crikeyk/PoV_display_PoC/Firmware/debug/capture/capture.csv

t_s | raw_counts | accel_g | phase_rad | position | omega_rad_s | pace_hz | locked | event
0.00000 | -11 | -0.08268 |  |  | 0.0000 |  | 0 | left_end
0.00293 | -29 | -0.22272 |  |  | 0.0000 |  | 0
0.00781 | -37 | -0.28496 |  |  | 0.0000 |  | 0
0.01074 | -56 | -0.43278 |  |  | 0.0000 |  | 0
0.01562 | -62 | -0.47946 |  |  | 0.0000 |  | 0
0.01855 | -73 | -0.56504 |  |  | 0.0000 |  | 0
0.02343 | -77 | -0.59616 |  |  | 0.0000 |  | 0
0.02636 | -81 | -0.62728 |  |  | 0.0000 |  | 0
0.03124 | -78 | -0.60394 |  |  | 0.0000 |  | 0
0.03417 | -67 | -0.51836 |  |  | 0.0000 |  | 0
0.03905 | -63 | -0.48724 |  |  | 0.0000 |  | 0
0.04198 | -56 | -0.43278 |  |  | 0.0000 |  | 0
0.04686 | -54 | -0.41722 |  |  | 0.0000 |  | 0
0.04979 | -50 | -0.38610 |  |  | 0.0000 |  | 0
0.05467 | -48 | -0.37054 |  |  | 0.0000 |  | 0
0.05760 | -45 | -0.34720 |  |  | 0.0000 |  | 0
0.06248 | -46 | -0.35498 |  |  | 0.0000 |  | 0
0.06541 | -46 | -0.35498 |  |  | 0.0000 |  | 0
0.07029 | -46 | -0.35498 |  |  | 0.0000 |  | 0
0.07322 | -46 | -0.35498 |  |  | 0.0000 |  | 0
0.07810 | -47 | -0.36276 |  |  | 0.0000 |  | 0
0.08103 | -47 | -0.36276 |  |  | 0.0000 |  | 0
0.08591 | -50 | -0.38610 |  |  | 0.0000 |  | 0
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
