crikeyk/PoV_display_PoC/PCB/POV display.kicad_pcb

## KiCad design PCB/POV display.kicad_pcb (2026-10-05)

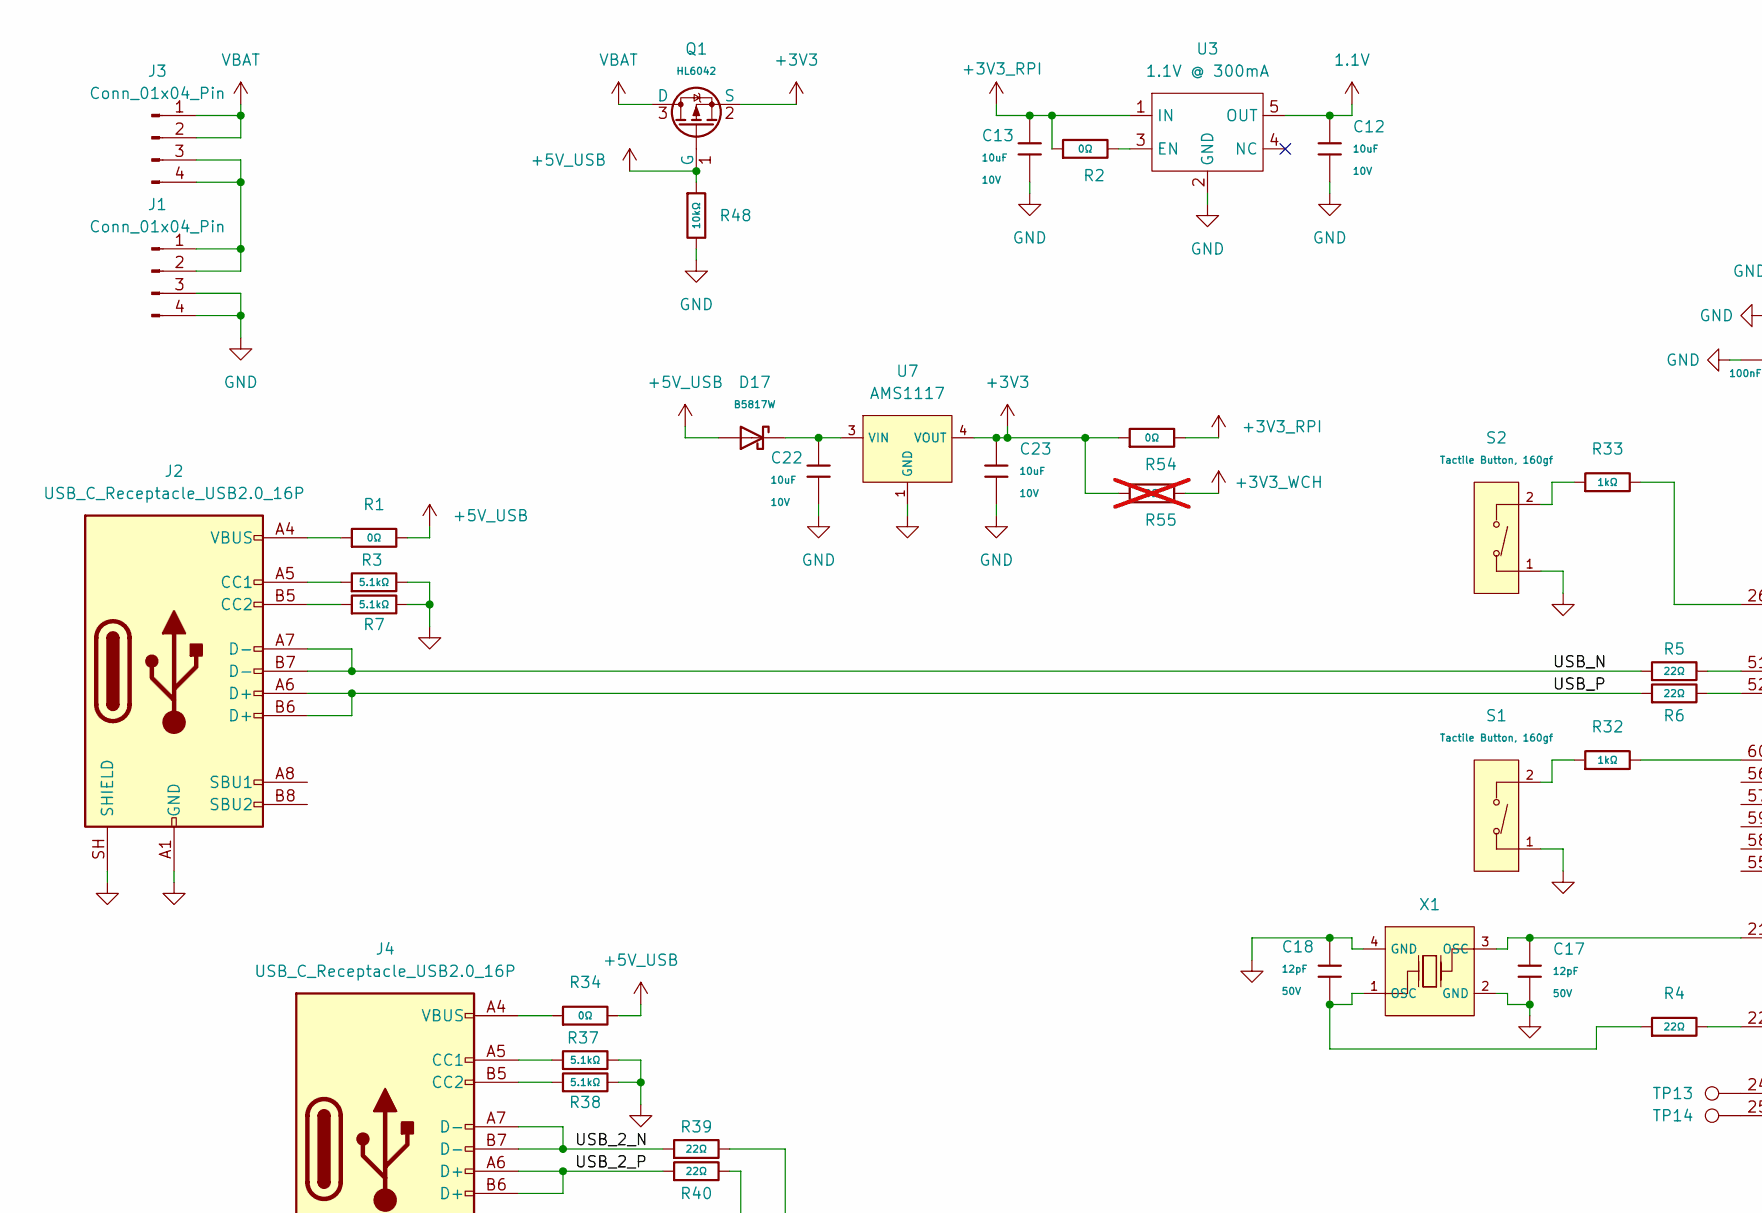
[picture p1: schematic POV display.kicad_sch, part in row 1, column 1]

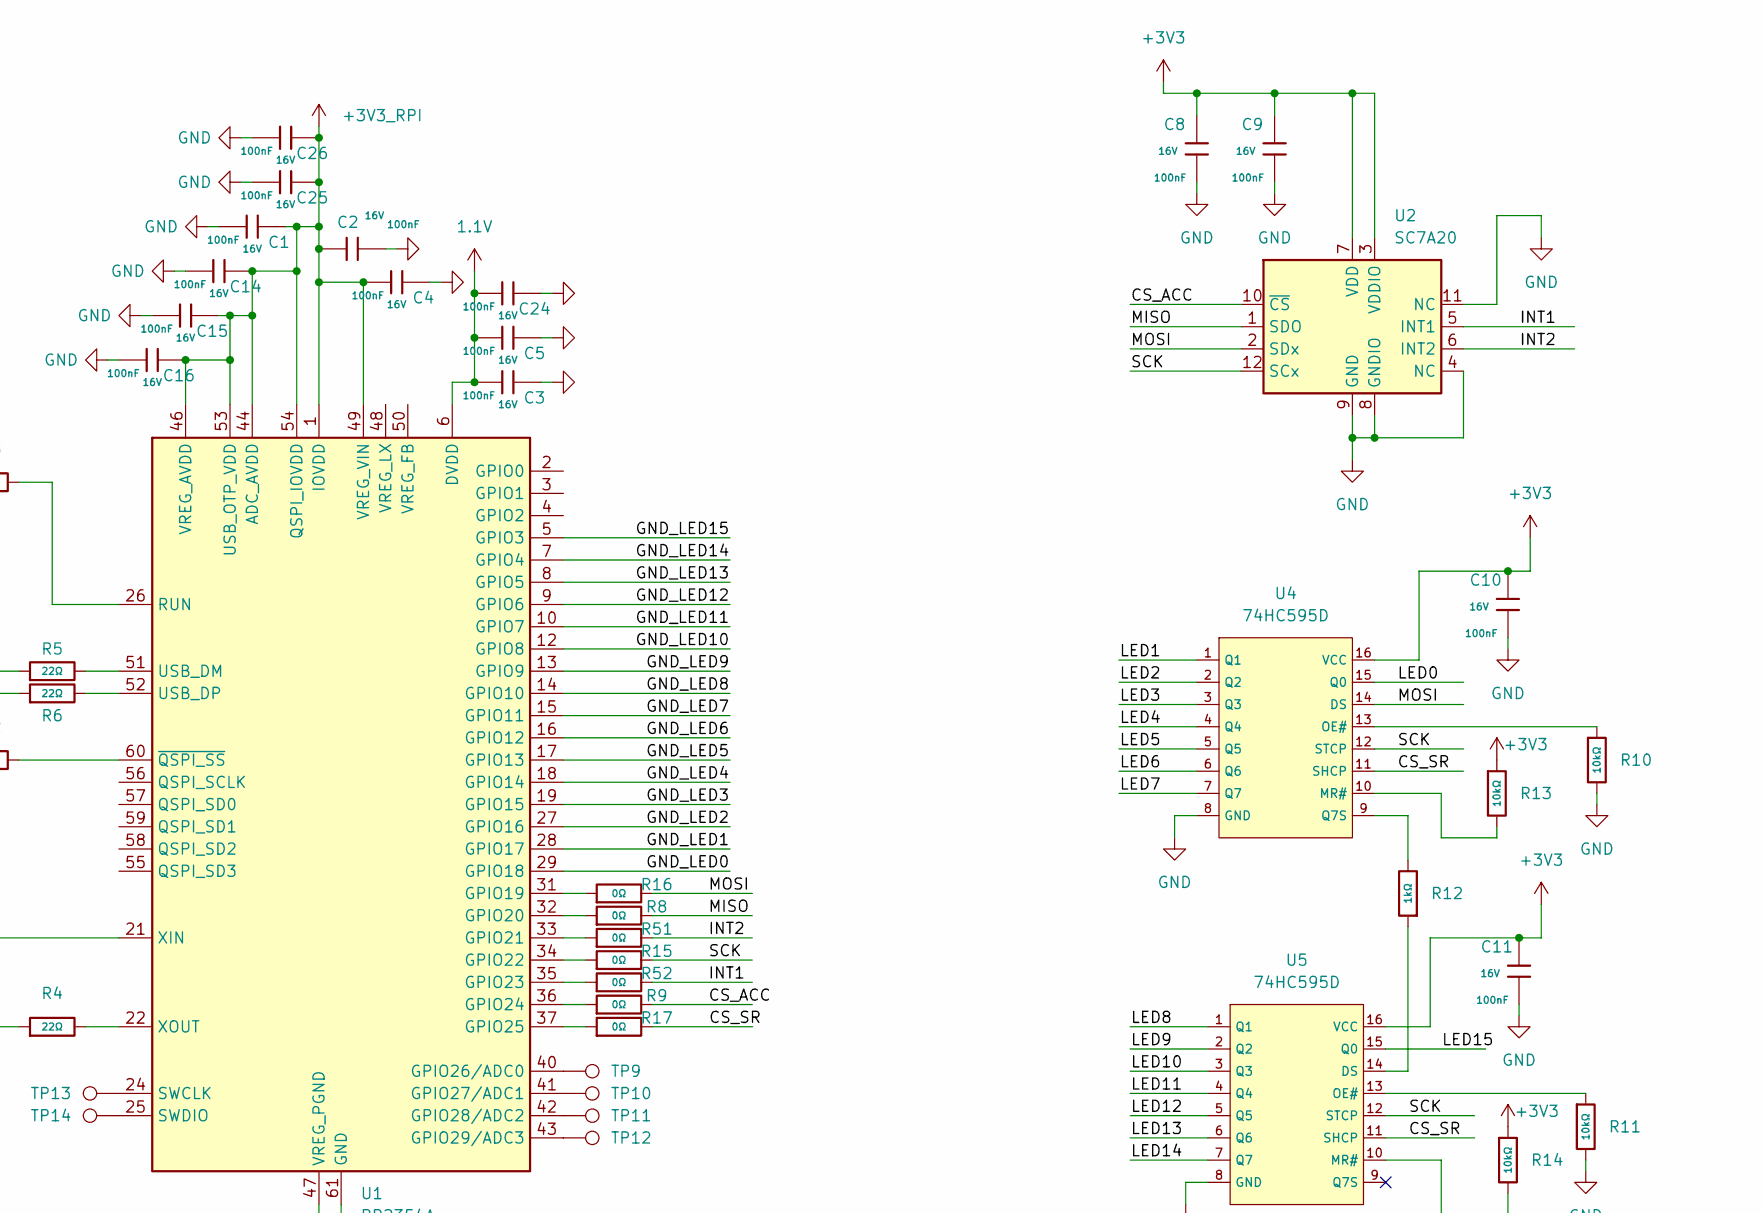
[picture p2: schematic POV display.kicad_sch, part in row 1, column 2]

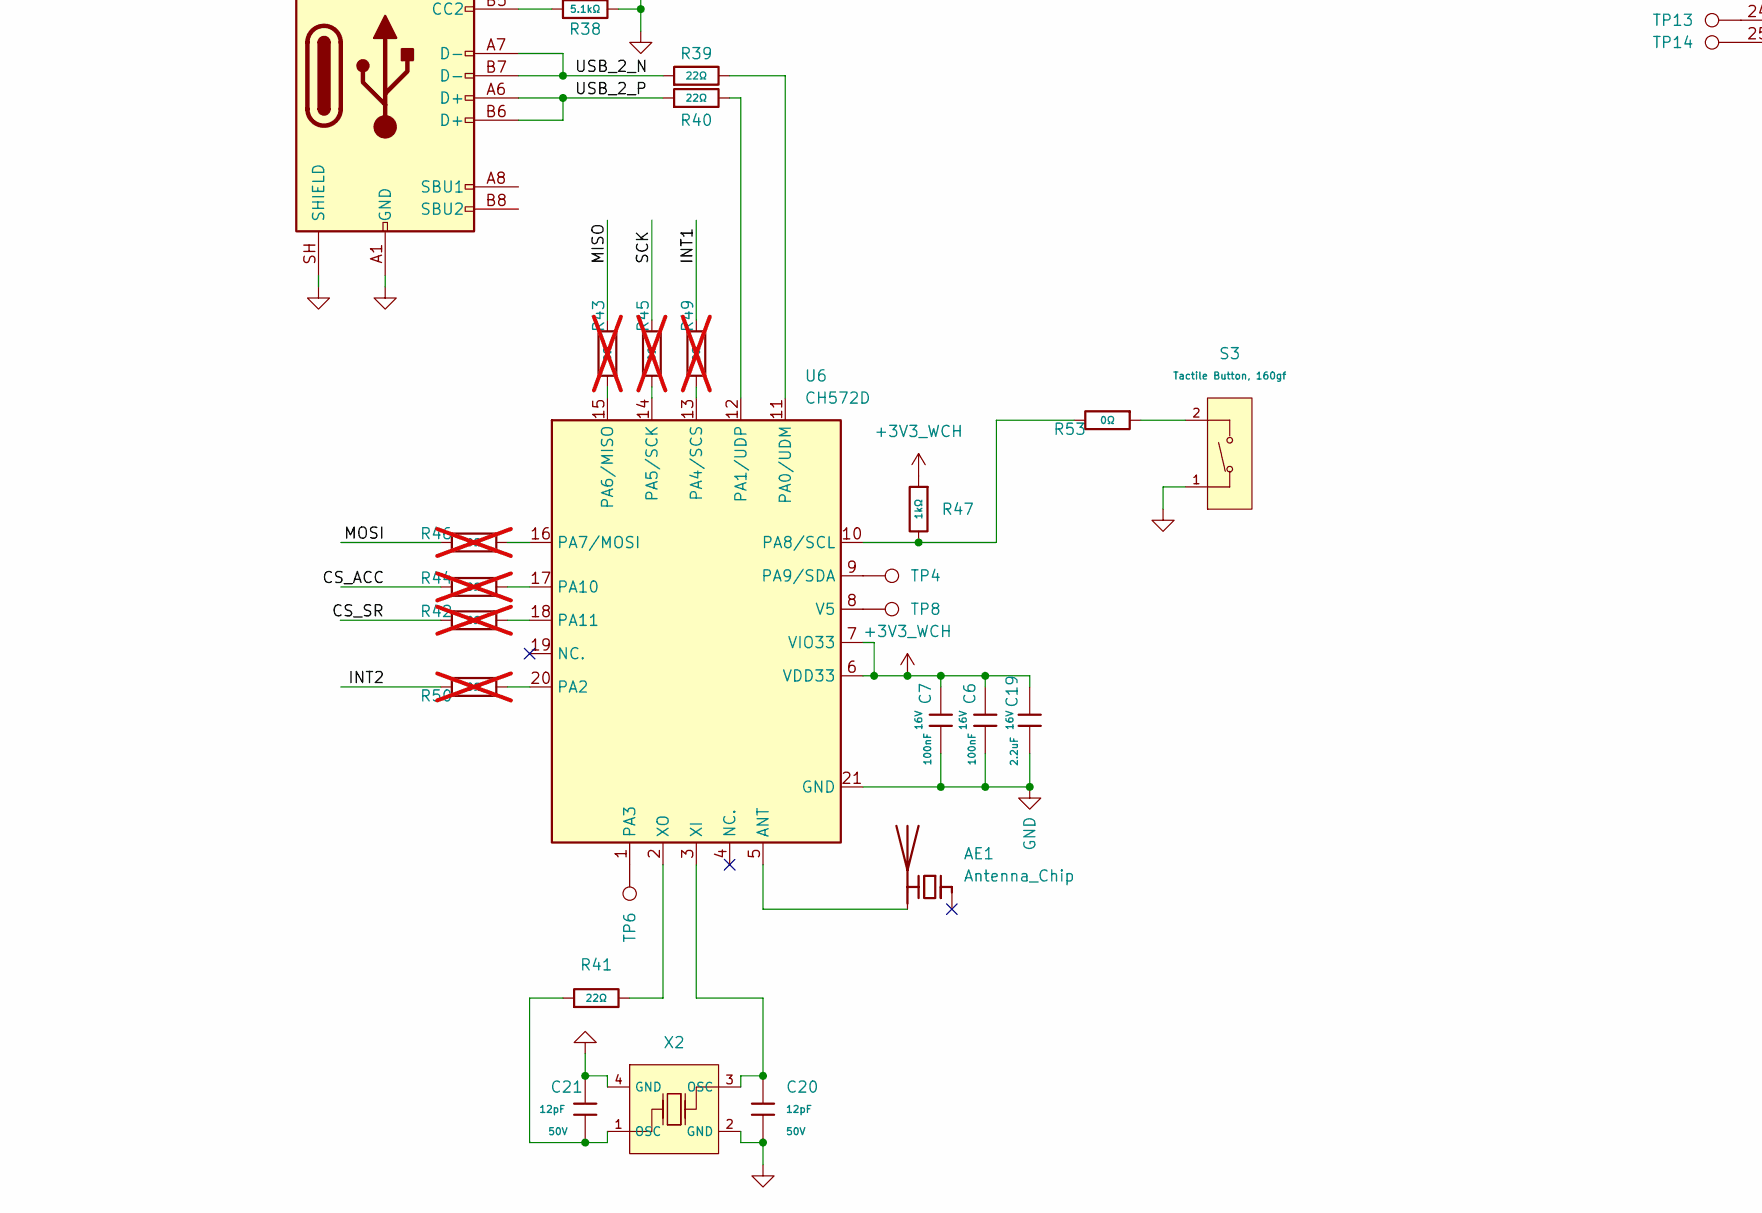
[picture p3: schematic POV display.kicad_sch, part in row 2, column 1]

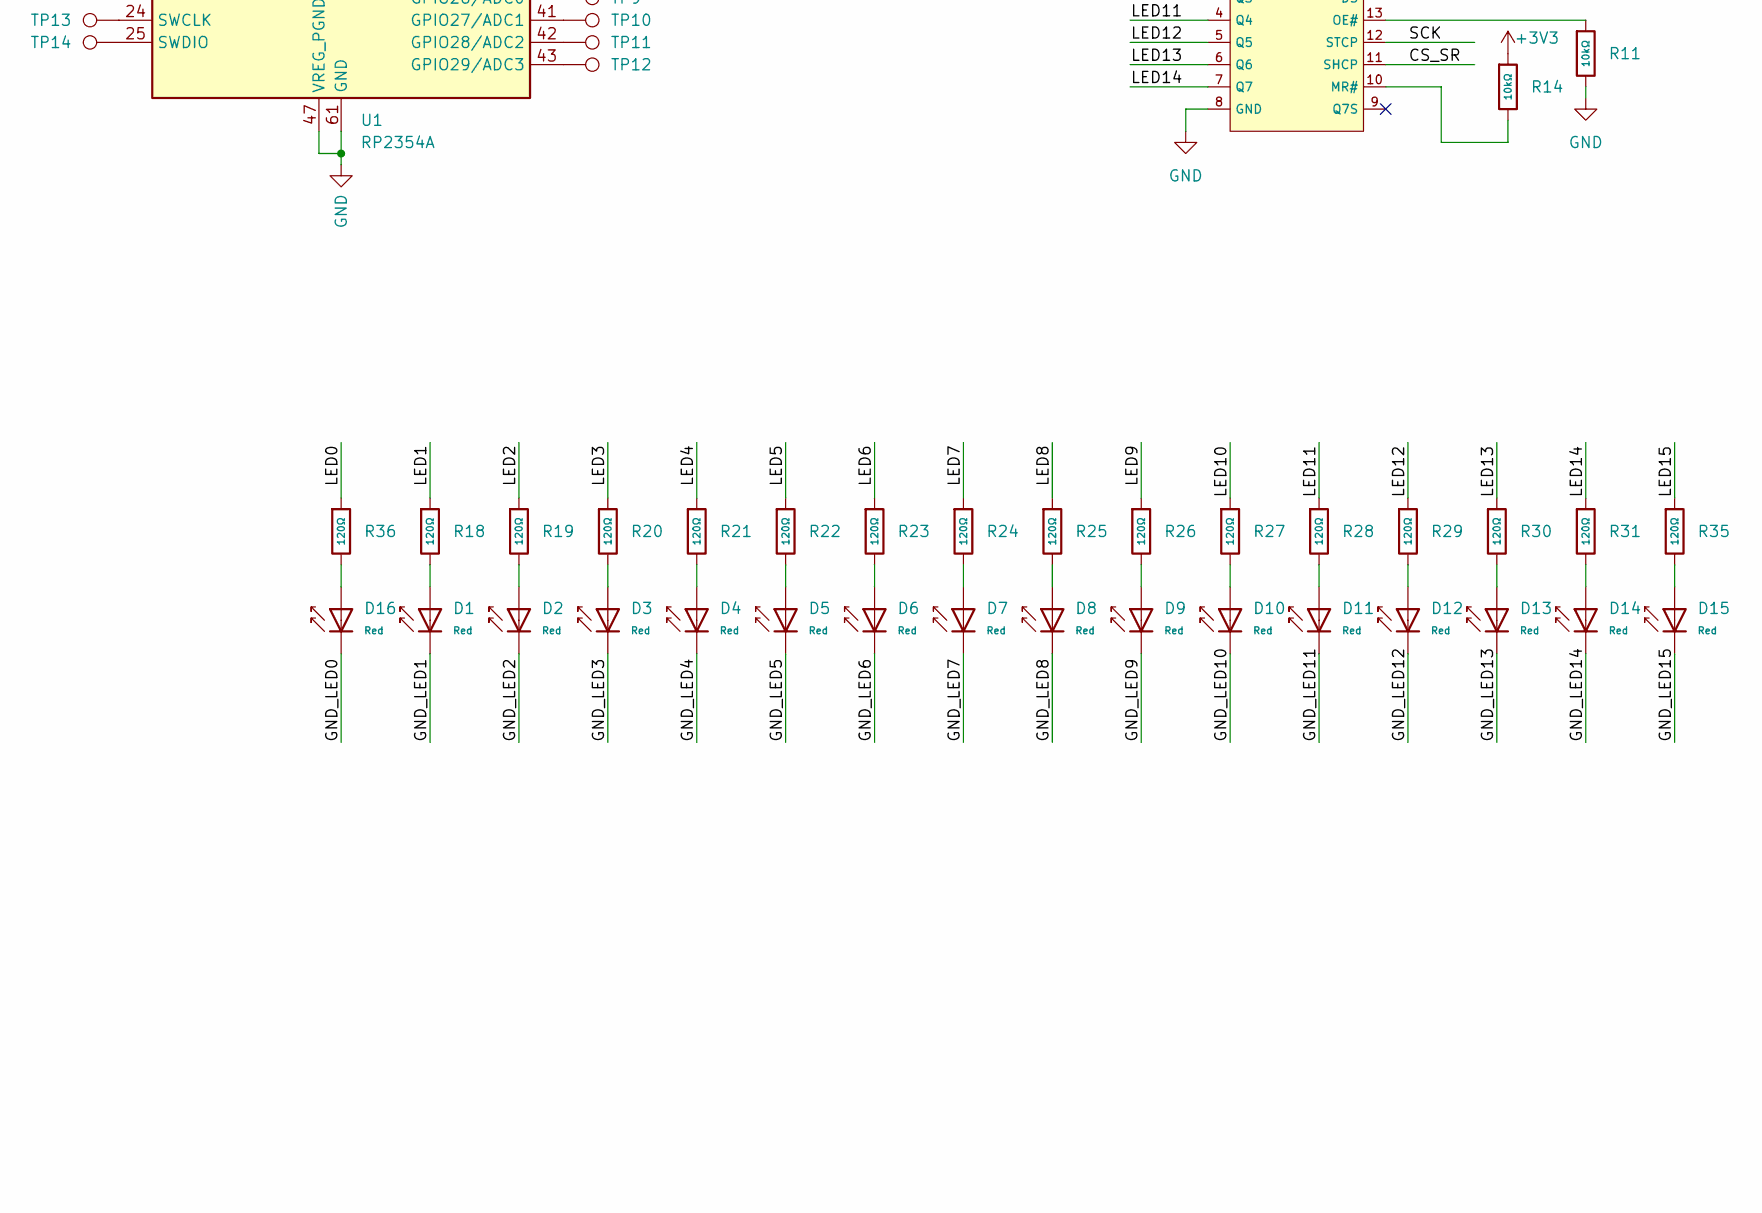
[picture p4: schematic POV display.kicad_sch, part in row 2, column 2]

Parts:
AE1: Antenna_Chip; C_1206_3216Metric; LCSC C127629
C1, C2, C3, C4, C5, C6, C7, C8, C9, C10, C11, C14, C15, C16, C24, C25, C26: 100nF; C_0402; Voltage Rated 16V; Tolerance ±10%; Part CL05B104KO5NNNC; LCSC C1525
C12, C13, C22, C23: 10uF; C_0603; Voltage Rated 10V; Tolerance ±10%; Part CL10A106KP8NNNC; LCSC C19702
C17, C18, C20, C21: 12pF; C_0402; Voltage Rated 50V; Tolerance ±5%; Part 0402CG120J500NT; LCSC C1547
C19: 2.2uF; C_0603; Voltage Rated 16V; Tolerance ±10%; Part CL10A225KO8NNNC; LCSC C23630
D1, D2, D3, D4, D5, D6, D7, D8, D9, D10, D11, D12, D13, D14, D15, D16: Red; D_0603; Part KT-0603R; LCSC C2286
D17: B5817W; D_SOD-123; Forward Voltage (Vf@If) 0.45V@1.0A; Reverse Voltage (Vr) 20V; Part B5817W; LCSC C7420328
J1, J3: Conn_01x04_Pin; BC-8200 AAA Battery clip
J2, J4: USB_C_Receptacle_USB2.0_16P; USB_C_Receptacle_HRO_TYPE-C-31-M-12; LCSC C165948
Q1: HL6042; Q_SOT-23; Part HL6042; LCSC C28646264
R1, R2, R8, R9, R15, R16, R17, R34, R51, R52, R53, R54: 0Ω; R_0402; Overload Voltage (Max) 50V; Tolerance ±1%; Part 0402WGF0000TCE; LCSC C17168
R3, R7, R37, R38: 5.1kΩ; R_0402; Overload Voltage (Max) 50V; Tolerance ±1%; Part 0402WGF5101TCE; LCSC C25905
R4, R5, R6, R39, R40, R41: 22Ω; R_0402; Overload Voltage (Max) 50V; Tolerance ±1%; Part 0402WGF220JTCE; LCSC C25092
R10, R11, R13, R14: 10kΩ; R_0603; Overload Voltage (Max) 75V; Tolerance ±1%; Part 0603WAF1002T5E; LCSC C25804
R12: 1kΩ; R_0603; Overload Voltage (Max) 75V; Tolerance ±1%; Part 0603WAF1001T5E; LCSC C21190
R18, R19, R20, R21, R22, R23, R24, R25, R26, R27, R28, R29, R30, R31, R35, R36: 120Ω; R_0603; Overload Voltage (Max) 75V; Tolerance ±1%; Part 0603WAF1200T5E; LCSC C22787
R32, R33, R47: 1kΩ; R_0402; Overload Voltage (Max) 50V; Tolerance ±1%; Part 0402WGF1001TCE; LCSC C11702
R42, R43, R44, R45, R46, R49, R50, R55: 0Ω; R_0402; Overload Voltage (Max) 50V; Tolerance ±1%; Part 0402WGF0000TCE; LCSC C17168; not fitted
R48: 10kΩ; R_0402; Overload Voltage (Max) 50V; Tolerance ±1%; Part 0402WGF1002TCE; LCSC C25744
S1, S2, S3: Tactile Button, 160gf; SW_TS-1088-AR02016; Voltage Rating (Dc) 12V; Part TS-1088-AR02016; LCSC C720477
TP4, TP6, TP8, TP9, TP10, TP11, TP12, TP13, TP14: TestPoint; TestPoint_Pad_D1.0mm
U1: RP2354A; QFN-60-1EP_7x7mm_P0.4mm_EP3.4x3.4mm; LCSC C41378174
U2: SC7A20; LGA-12_2x2mm_P0.5mm; LCSC C19274408
U3: 1.1V @ 300mA; SOT-23-5; LCSC C485147
U4, U5: 74HC595D; SOIC-16_L9.9-W3.9-P1.27-LS6.0-BL; Supply Voltage 2V~6V; Part 74HC595D,118; LCSC C5947
U6: CH572D; QFN-20-1EP_3x3mm_P0.4mm_EP1.65x1.65mm
U7: AMS1117; SOT-223-3_L6.5-W3.4-P2.30-LS7.0-BR; Output Voltage 3.3V; Dropout Voltage 1.3V@(800mA); Part AMS1117-3.3; LCSC C6186
X1: X322512MSB4SI; CRYSTAL-SMD_4P-L3.2-W2.5-BL; Frequency Tolerance ±10ppm; Part X322512MSB4SI; LCSC C9002
X2: Y201632MFBCX; Crystal_SMD_2016-4Pin_2.0x1.6mm; Frequency Tolerance ±10ppm; Part Y201632MFBCX; LCSC C49158176

Connections:
1.1V: C3.2, C5.2, C12.1, C24.2, U1.6 (DVDD), U1.23 (DVDD), U1.39 (DVDD), U3.5 (OUT)
+3V3: C8.1, C9.1, C10.1, C11.1, C23.1, Q1.2 (S), R13.1, R14.1, R54.1, R55.1, U2.3 (VDDIO), U2.7 (VDD), U4.16 (VCC), U5.16 (VCC), U7.2 (VOUT), U7.4 (VOUT)
+3V3_RPI: C1.1, C2.1, C4.2, C13.1, C14.1, C15.1, C16.1, C25.1, C26.1, R2.1, R54.2, U1.1 (IOVDD), U1.11 (IOVDD), U1.20 (IOVDD), U1.30 (IOVDD), U1.38 (IOVDD), U1.44 (ADC_AVDD), U1.45 (IOVDD), U1.46 (VREG_AVDD), U1.49 (VREG_VIN), U1.53 (USB_OTP_VDD), U1.54 (QSPI_IOVDD), U3.1 (IN)
+3V3_WCH: C6.1, C7.1, C19.1, R47.1, R55.2, U6.6 (VDD33), U6.7 (VIO33)
+5V_USB: D17.2, Q1.1 (G), R1.2, R34.2, R48.1
/CS_ACC: R9.2, R44.2, U2.10 (~CS)
/CS_SR: R17.2, R42.2, U4.11 (SHCP), U5.11 (SHCP)
/GND_LED0: D16.1, U1.29 (GPIO18)
/GND_LED1: D1.1, U1.28 (GPIO17)
/GND_LED2: D2.1, U1.27 (GPIO16)
/GND_LED3: D3.1, U1.19 (GPIO15)
/GND_LED4: D4.1, U1.18 (GPIO14)
/GND_LED5: D5.1, U1.17 (GPIO13)
/GND_LED6: D6.1, U1.16 (GPIO12)
/GND_LED7: D7.1, U1.15 (GPIO11)
/GND_LED8: D8.1, U1.14 (GPIO10)
/GND_LED9: D9.1, U1.13 (GPIO9)
/GND_LED10: D10.1, U1.12 (GPIO8)
/GND_LED11: D11.1, U1.10 (GPIO7)
/GND_LED12: D12.1, U1.9 (GPIO6)
/GND_LED13: D13.1, U1.8 (GPIO5)
/GND_LED14: D14.1, U1.7 (GPIO4)
/GND_LED15: D15.1, U1.5 (GPIO3)
/INT1: R49.2, R52.2, U2.5 (INT1)
/INT2: R50.2, R51.2, U2.6 (INT2)
/LED0: R36.1, U4.15 (Q0)
/LED1: R18.1, U4.1 (Q1)
/LED2: R19.1, U4.2 (Q2)
/LED3: R20.1, U4.3 (Q3)
/LED4: R21.1, U4.4 (Q4)
/LED5: R22.1, U4.5 (Q5)
/LED6: R23.1, U4.6 (Q6)
/LED7: R24.1, U4.7 (Q7)
/LED8: R25.1, U5.1 (Q1)
/LED9: R26.1, U5.2 (Q2)
/LED10: R27.1, U5.3 (Q3)
/LED11: R28.1, U5.4 (Q4)
/LED12: R29.1, U5.5 (Q5)
/LED13: R30.1, U5.6 (Q6)
/LED14: R31.1, U5.7 (Q7)
/LED15: R35.1, U5.15 (Q0)
/MISO: R8.2, R43.2, U2.1 (SDO)
/MOSI: R16.2, R46.2, U2.2 (SDx), U4.14 (DS)
/SCK: R15.2, R45.2, U2.12 (SCx), U4.12 (STCP), U5.12 (STCP)
/USB_2_N: J4.A7 (D-), J4.B7 (D-), R39.1
/USB_2_P: J4.A6 (D+), J4.B6 (D+), R40.1
/USB_N: J2.A7 (D-), J2.B7 (D-), R5.1
/USB_P: J2.A6 (D+), J2.B6 (D+), R6.1
GND: C1.2, C2.2, C3.1, C4.1, C5.1, C6.2, C7.2, C8.2, C9.2, C10.2, C11.2, C12.2, C13.2, C14.2, C15.2, C16.2, C17.2, C18.2, C19.2, C20.2, C21.2, C22.2, C23.2, C24.1, C25.2, C26.2, J1.3, J1.4, J2.A1 (GND), J2.A12 (GND), J2.B1 (GND), J2.B12 (GND), J2.SH (SHIELD), J4.A1 (GND), J4.A12 (GND), J4.B1 (GND), J4.B12 (GND), J4.SH (SHIELD), R3.2, R7.2, R10.2, R11.2, R37.2, R38.2, R48.2, S1.1 (A), S2.1 (A), S3.1 (A), U1.47 (VREG_PGND), U1.61 (GND), U2.4 (NC), U2.8 (GNDIO), U2.9 (GND), U2.11 (NC), U3.2 (GND), U4.8 (GND), U5.8 (GND), U6.21 (GND), U7.1 (GND), X1.2 (GND), X1.4 (GND), X2.2 (GND), X2.4 (GND)
unnamed: AE1.2 (PCB_Trace_2), U6.5 (ANT)
unnamed: C18.1, R4.1, X1.1 (OSC)
unnamed: C21.1, R41.1, X2.1 (OSC)
unnamed: D1.2, R18.2
unnamed: D2.2, R19.2
unnamed: D3.2, R20.2
unnamed: D4.2, R21.2
unnamed: D5.2, R22.2
unnamed: D6.2, R23.2
unnamed: D7.2, R24.2
unnamed: D8.2, R25.2
unnamed: D9.2, R26.2
unnamed: D10.2, R27.2
unnamed: D11.2, R28.2
unnamed: D12.2, R29.2
unnamed: D13.2, R30.2
unnamed: D14.2, R31.2
unnamed: D15.2, R35.2
unnamed: D16.2, R36.2
unnamed: J1.1, J1.2, J3.3, J3.4
unnamed: J2.A5 (CC1), R3.1
unnamed: J2.B5 (CC2), R7.1
unnamed: J2.A4 (VBUS), J2.A9 (VBUS), J2.B4 (VBUS), J2.B9 (VBUS), R1.1
unnamed: J4.A5 (CC1), R37.1
unnamed: J4.B5 (CC2), R38.1
unnamed: J4.A4 (VBUS), J4.A9 (VBUS), J4.B4 (VBUS), J4.B9 (VBUS), R34.1
unnamed: R32.1, S1.2 (B)
unnamed: R33.1, S2.2 (B)
unnamed: R53.1, S3.2 (B)
unnamed: R16.1, U1.31 (GPIO19)
unnamed: R8.1, U1.32 (GPIO20)
unnamed: R51.1, U1.33 (GPIO21)
unnamed: R15.1, U1.34 (GPIO22)
unnamed: R52.1, U1.35 (GPIO23)
unnamed: R9.1, U1.36 (GPIO24)
unnamed: R17.1, U1.37 (GPIO25)
unnamed: TP9.1 (1_1), U1.40 (GPIO26/ADC0)
unnamed: TP10.1 (1_1), U1.41 (GPIO27/ADC1)
unnamed: TP11.1 (1_1), U1.42 (GPIO28/ADC2)
unnamed: TP12.1 (1_1), U1.43 (GPIO29/ADC3)
unnamed: R33.2, U1.26 (RUN)
unnamed: TP13.1 (1_1), U1.24 (SWCLK)
unnamed: TP14.1 (1_1), U1.25 (SWDIO)
unnamed: R5.2, U1.51 (USB_DM)
unnamed: R6.2, U1.52 (USB_DP)
unnamed: C17.1, U1.21 (XIN), X1.3 (OSC)
unnamed: R4.2, U1.22 (XOUT)
unnamed: R32.2, U1.60 (~QSPI_SS)
unnamed: R2.2, U3.3 (EN)
unnamed: R13.2, U4.10 (MR#)
unnamed: R10.1, U4.13 (OE#)
unnamed: R12.2, U4.9 (Q7S)
unnamed: R12.1, U5.14 (DS)
unnamed: R14.2, U5.10 (MR#)
unnamed: R11.1, U5.13 (OE#)
unnamed: R39.2, U6.11 (PA0/UDM)
unnamed: R40.2, U6.12 (PA1/UDP)
unnamed: R50.1, U6.20 (PA2)
unnamed: TP6.1 (1_1), U6.1 (PA3)
unnamed: R49.1, U6.13 (PA4/SCS)
unnamed: R45.1, U6.14 (PA5/SCK)
unnamed: R43.1, U6.15 (PA6/MISO)
unnamed: R46.1, U6.16 (PA7/MOSI)
unnamed: R47.2, R53.2, U6.10 (PA8/SCL)
unnamed: TP4.1 (1_1), U6.9 (PA9/SDA)
unnamed: R44.1, U6.17 (PA10)
unnamed: R42.1, U6.18 (PA11)
unnamed: TP8.1 (1_1), U6.8 (V5)
unnamed: C20.1, U6.3 (XI), X2.3 (OSC)
unnamed: R41.2, U6.2 (XO)
unnamed: C22.1, D17.1, U7.3 (VIN)
VBAT: J3.1, J3.2, Q1.3 (D)

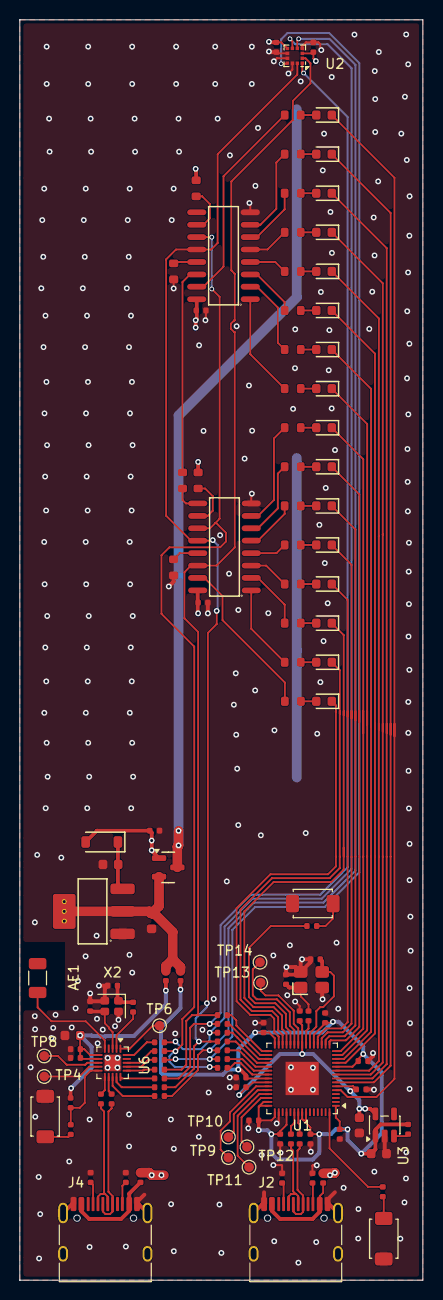
[picture p5: board POV display.kicad_pcb from above]

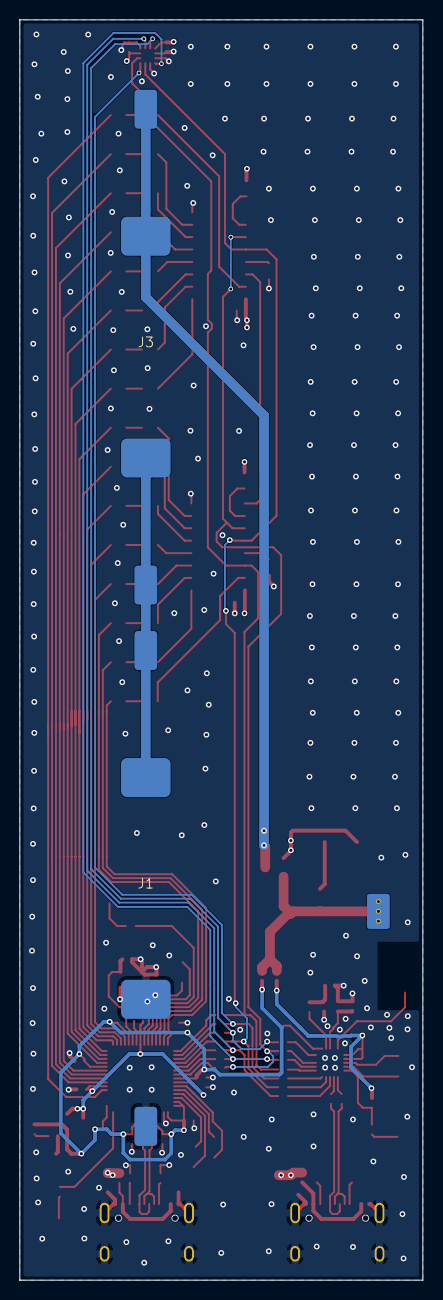
[picture p6: board POV display.kicad_pcb from below]

Board: 4 copper layers, 41.2 x 129.0 mm, 125 parts (2 on the bottom side), 121 nets.
