crikeyk/PoV_display_PoC/Firmware/ch572/src/peripheral_main.c

/********************************** (C) COPYRIGHT *******************************
 * File Name          : main.c
 * Author             : WCH
 * Version            : V1.1
 * Date               : 2020/08/06
 * Description        : 外设从机应用主函数及任务系统初始化
 *********************************************************************************
 * Copyright (c) 2021 Nanjing Qinheng Microelectronics Co., Ltd.
 * Attention: This software (modified or not) and binary are used for 
 * microcontroller manufactured by Nanjing Qinheng Microelectronics.
 *******************************************************************************/

/******************************************************************************/
/* 头文件包含 */
#include "CONFIG.h"
#include "HAL.h"
#include "gattprofile.h"
#include "peripheral.h"
#include "board.h"

void InitUSBDevPara(void);
void InitUSBDevice(void);
void USB_IRQProcessHandler(void);

/*********************************************************************
 * GLOBAL TYPEDEFS
 */
__attribute__((aligned(4))) uint32_t MEM_BUF[BLE_MEMHEAP_SIZE / 4];

#if(defined(BLE_MAC)) && (BLE_MAC == TRUE)
const uint8_t MacAddr[6] = {0x84, 0xC2, 0xE4, 0x03, 0x02, 0x02};
#endif

/*********************************************************************
 * @fn      Main_Circulation
 *
 * @brief   主循环
 *
 * @return  none
 */
__HIGH_CODE
__attribute__((noinline))
void Main_Circulation()
{
    while(1)
    {
        TMOS_SystemProcess();
        USB_IRQProcessHandler();
        board_poll();
    }
}

/*********************************************************************
 * @fn      main
 *
 * @brief   主函数
 *
 * @return  none
 */
int main(void)
{
    // 关闭两线调试
    R16_PIN_ALTERNATE &= ~RB_PIN_DEBUG_EN;
    HSECFG_Capacitance(HSECap_12p);          // board crystal is 32 MHz, 12 pF
    SetSysClock(CLK_SOURCE_HSE_PLL_100MHz);
#if(defined(HAL_SLEEP)) && (HAL_SLEEP == TRUE)
    GPIOA_ModeCfg(GPIO_Pin_All, GPIO_ModeIN_PU);
#endif
    board_init();
    InitUSBDevPara();
    InitUSBDevice();
    board_log("POV> ready\n");
    CH57x_BLEInit();
    HAL_Init();
    GAPRole_PeripheralInit();
    Peripheral_Init();
    Main_Circulation();
}

/******************************** endfile @ main ******************************/
