crikeyk/PoV_display_PoC/(commit log)

2026-08-25 added CH570 mcu
    [POV display.kicad_pcb, POV display.kicad_sch]
2026-10-05 firmware initial complete
    [POV display.kicad_pcb, POV display.kicad_sch, bom.csv, designators.csv, positions.csv]
2026-10-14 Put the RP2350 wand in one folder and keep v6 as a tag.
    Firmware/device is what gets copied onto the wand. Debug capture tools are separate, and the handover notes are AGENTS.md.
2026-11-04 fixed accelerometer wake
